ndxw/RemmyMouse/images/20250518_114405.jpg

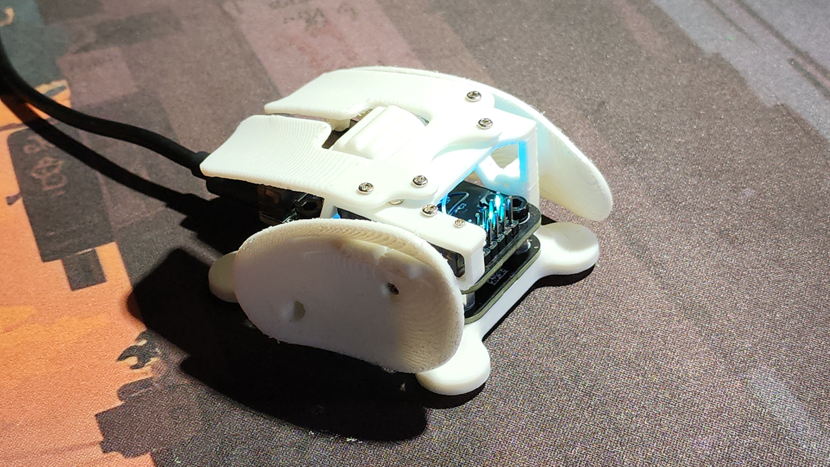
images/20250518_114405.jpg
