ndxw/RemmyMouse/images/20250515_183457.jpg

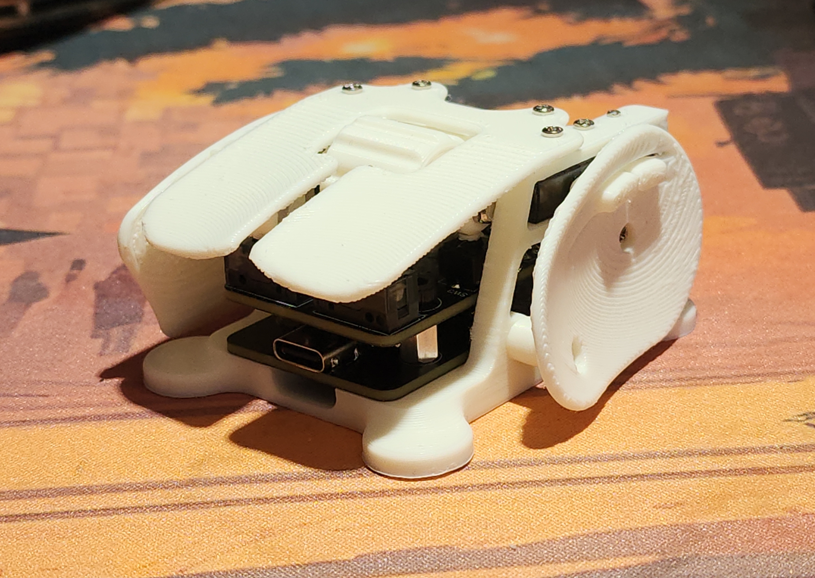
images/20250515_183457.jpg
