ndxw/RemmyMouse/README.md

Remmy uses PJRC's USB mouse library found [here](https://www.pjrc.com/teensy/usb_mouse.html), modified to support five mouse buttons.
