ndxw/RemmyMouse/images/20250515_020344.jpg

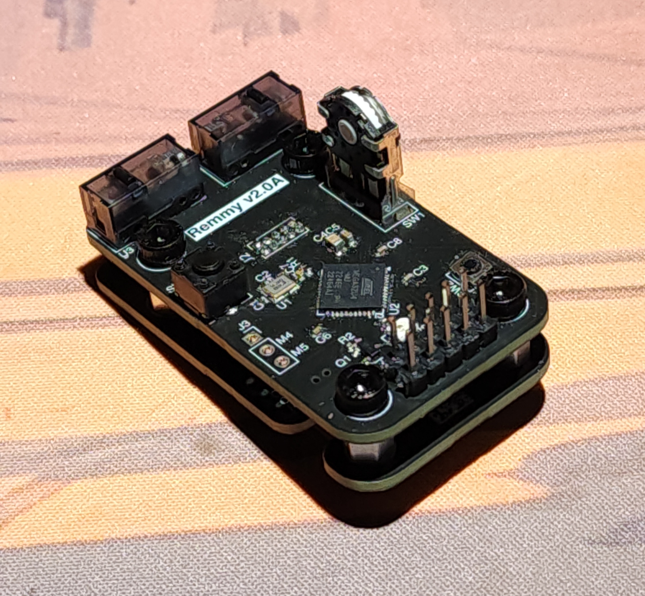
images/20250515_020344.jpg
