ndxw/RemmyMouse/images/20250515_122816.jpg

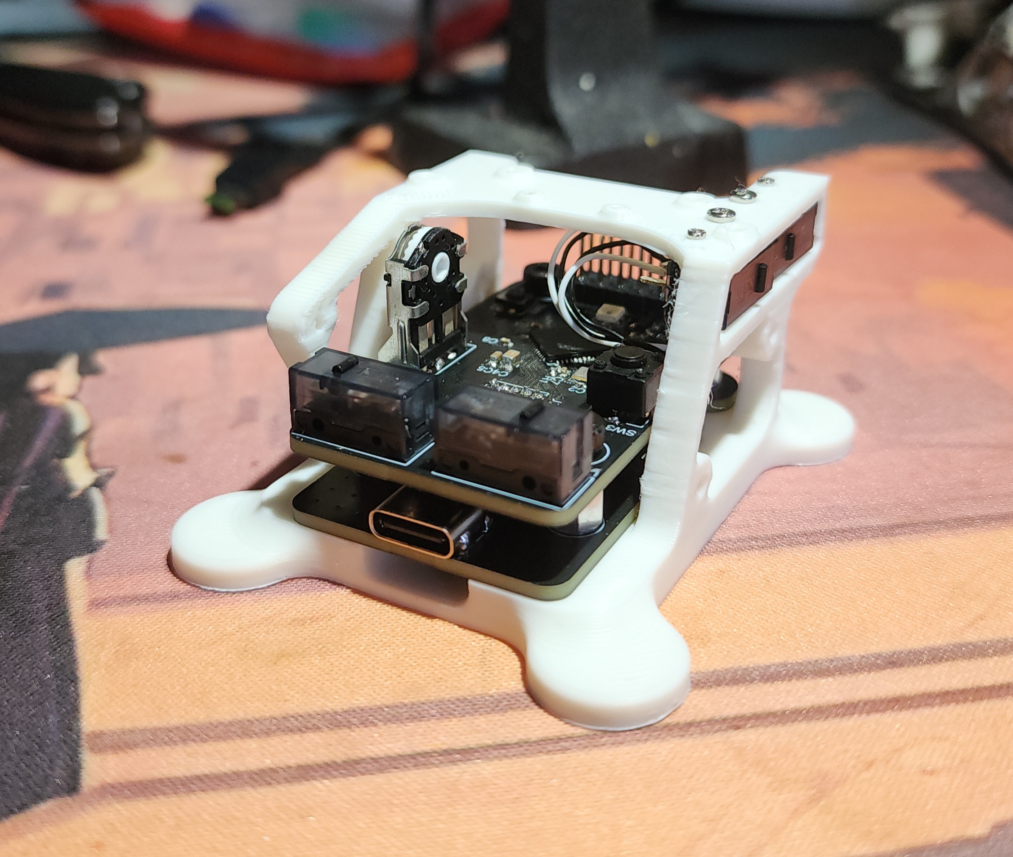
images/20250515_122816.jpg
