ndxw/RemmyMouse/images/20250515_183445.jpg

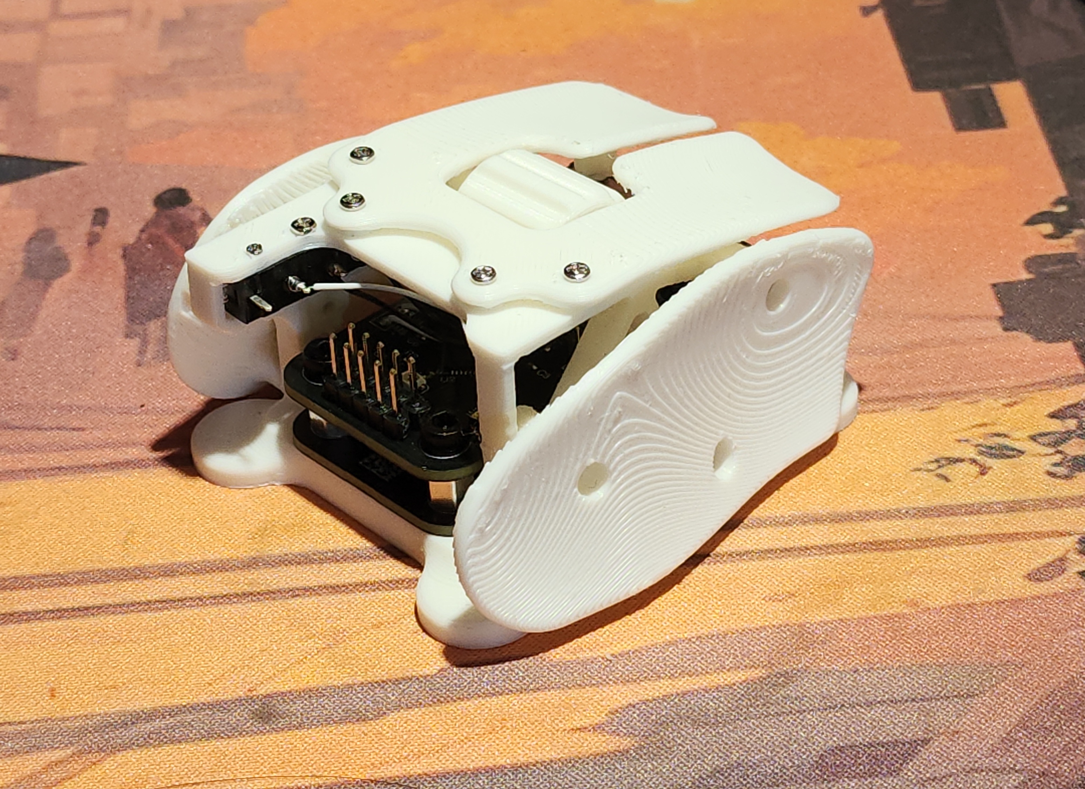
images/20250515_183445.jpg
