ndxw/RemmyMouse/images/20250518_114415.jpg

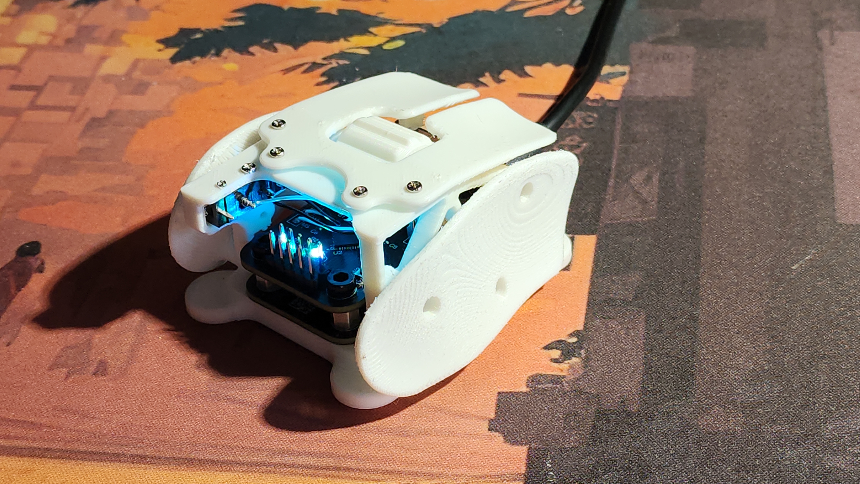
images/20250518_114415.jpg
