ndxw/RemmyMouse/images/20250518_114450.jpg

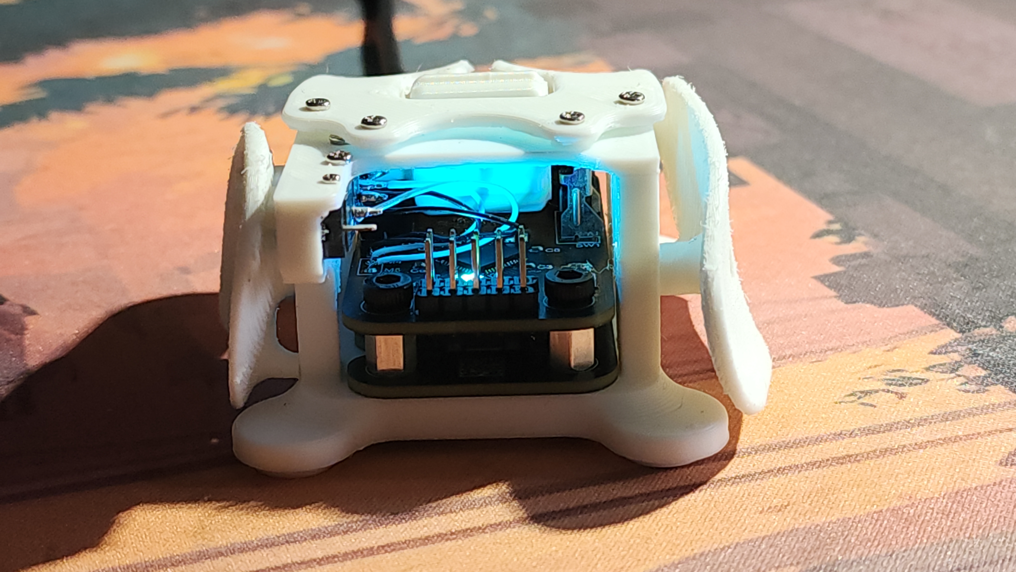
images/20250518_114450.jpg
