ndxw/RemmyMouse/images/remmy_mcu_board_layout.png

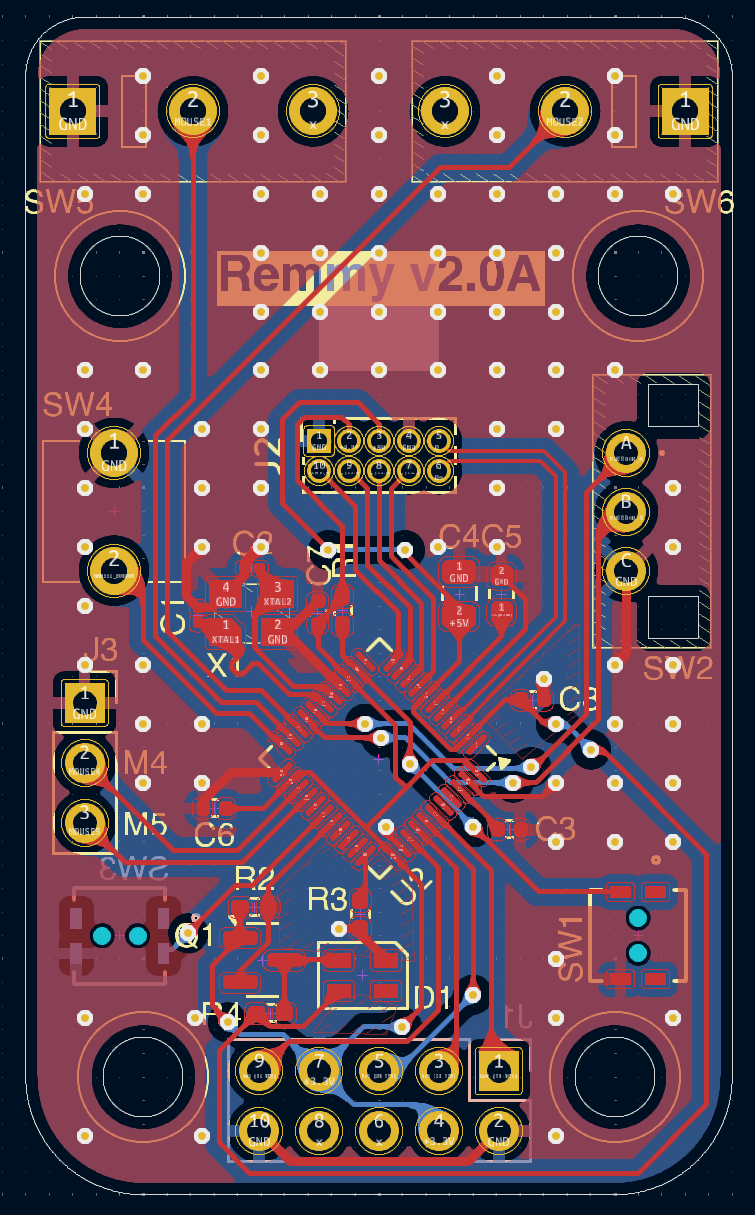
images/remmy_mcu_board_layout.png
