ndxw/RemmyMouse/images/remmy_sensor_board_layout.png

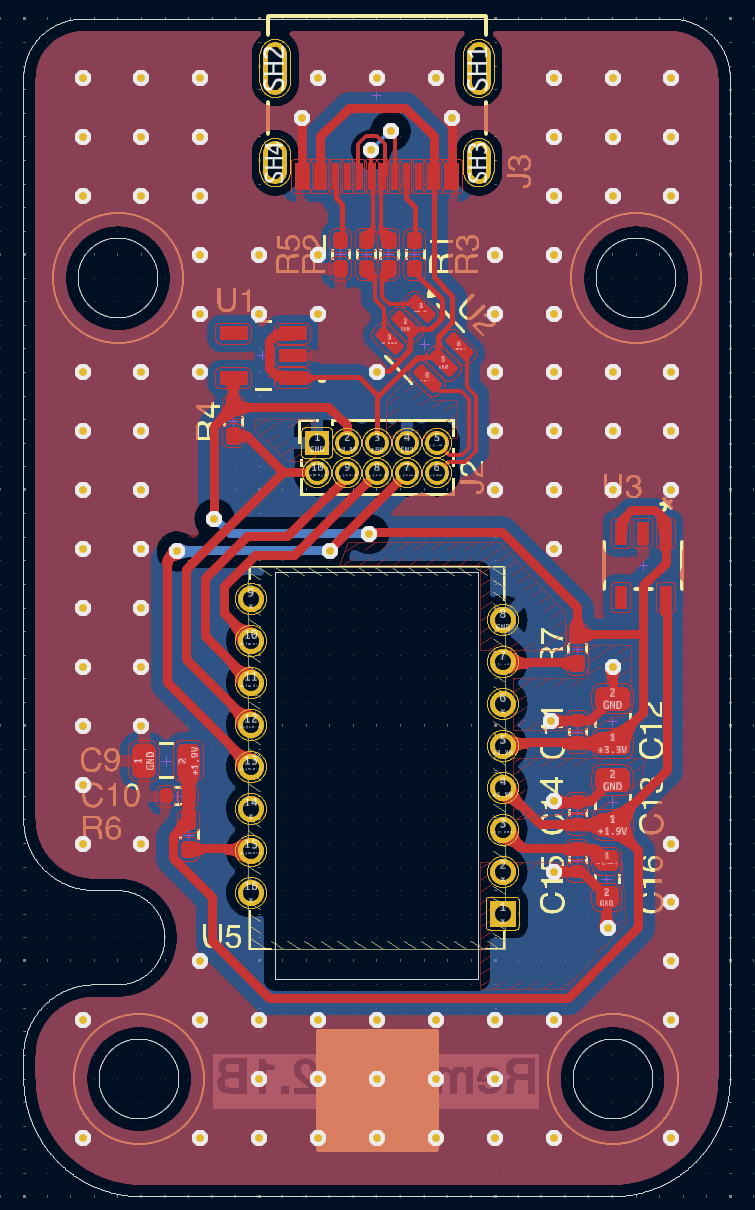
images/remmy_sensor_board_layout.png
