ndxw/RemmyMouse/CAD/shell/stl/thumb_pad_shortened.stl

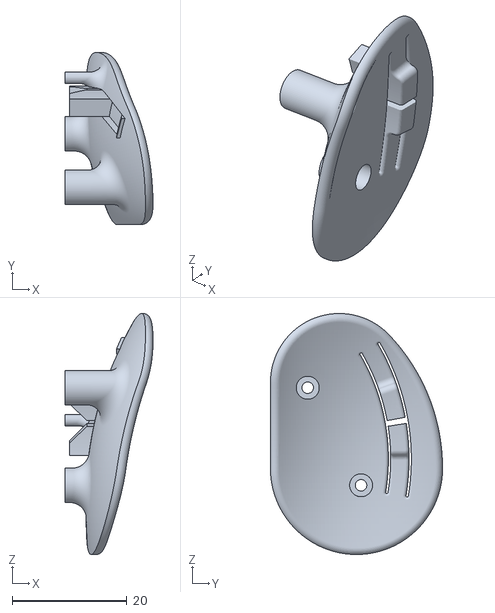
[picture p10: CAD file, 2025-06-22]
CAD/shell/stl/thumb_pad_shortened.stl
15.3 x 30.0 x 42.0
