ndxw/RemmyMouse/CAD/shell/stl/scroll_wheel_with_axle_1.65mm.stl

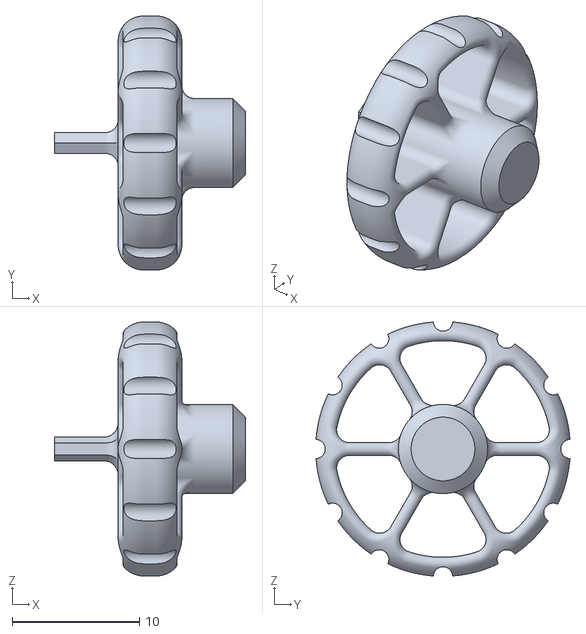
[picture p11: CAD file, 2025-06-22]
CAD/shell/stl/scroll_wheel_with_axle_1.65mm.stl
15.0 x 19.9 x 19.9
