ndxw/RemmyMouse/CAD/shell/stl/pinky_pad_v2.stl

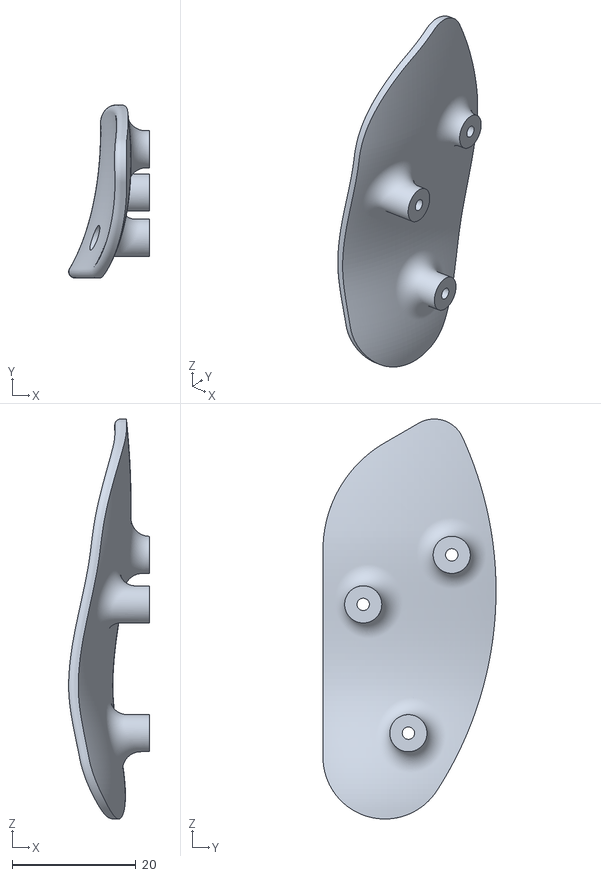
[picture p12: CAD file, 2025-06-22]
CAD/shell/stl/pinky_pad_v2.stl
13.0 x 28.0 x 64.6
