ndxw/RemmyMouse/CAD/shell/stl/mouse_buttons_1-2_reduced_width.stl

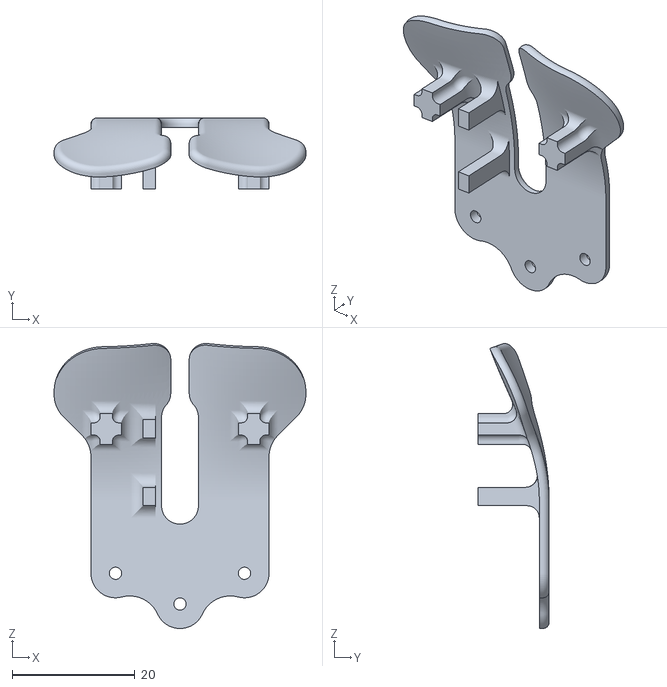
[picture p13: CAD file, 2025-06-22]
CAD/shell/stl/mouse_buttons_1-2_reduced_width.stl
41.0 x 11.6 x 46.4
