ndxw/RemmyMouse/CAD/shell/stl/scroll_wheel.stl

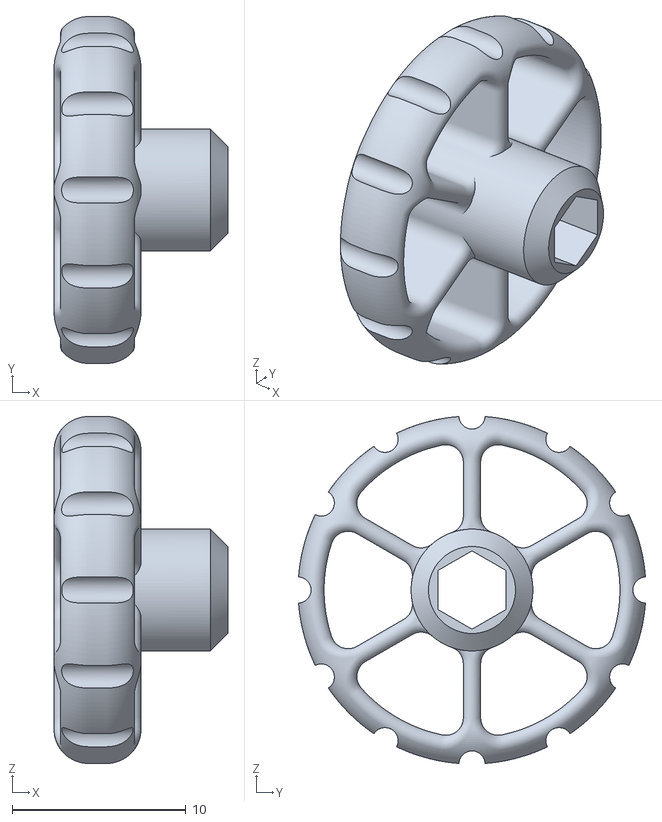
[picture p14: CAD file, 2025-06-22]
CAD/shell/stl/scroll_wheel.stl
10.0 x 19.9 x 19.9
