ndxw/RemmyMouse/CAD/shell/stl/SHELL.3mf

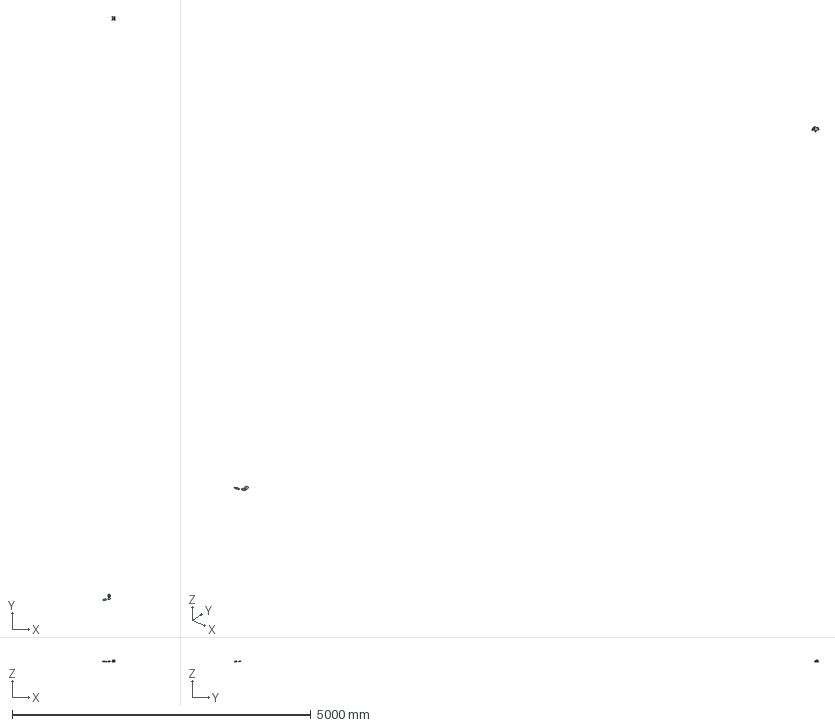
[picture p15: CAD file, 2025-06-12]
CAD/shell/stl/SHELL.3mf
207.3 x 9777.2 x 30.0 mm
base_plate.stl
mouse_buttons_1-2.stl
pinky_pad_v2.stl
thumb_pad_shortened.stl
