ndxw/RemmyMouse/CAD/shell/stl/mouse_buttons_1-2.stl

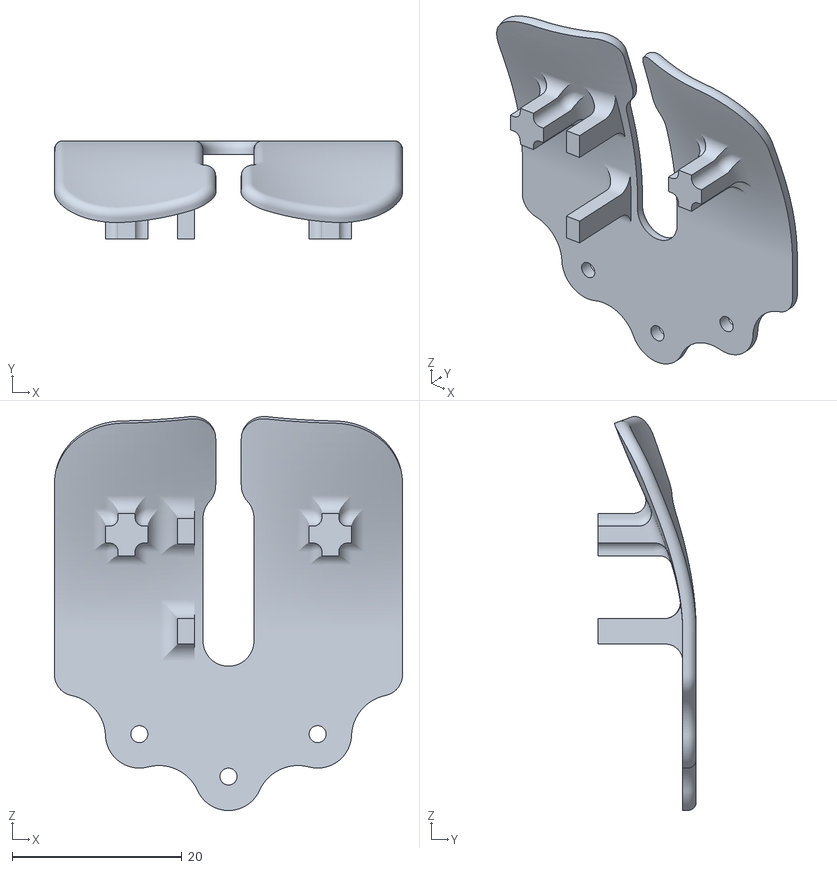
[picture p16: CAD file, 2025-06-12]
CAD/shell/stl/mouse_buttons_1-2.stl
41.0 x 11.6 x 46.4
