ndxw/RemmyMouse/CAD/shell/stl/mouse_button_extension.stl

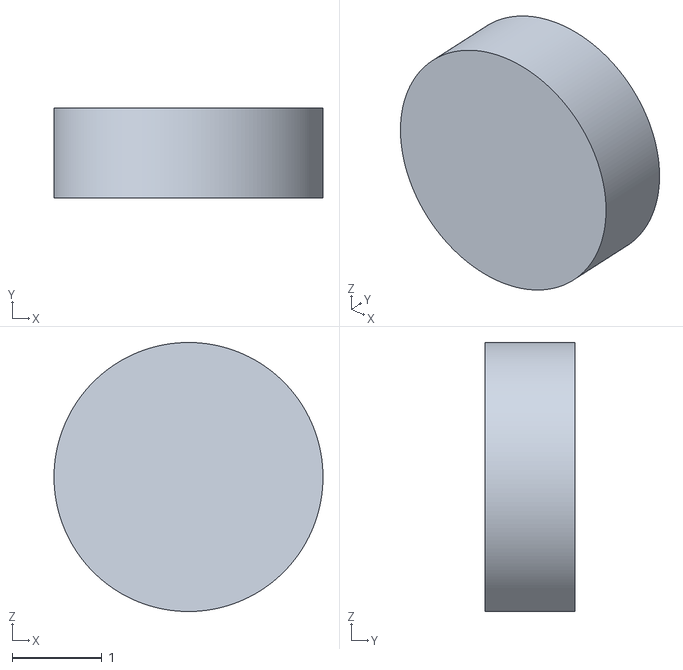
[picture p17: CAD file, 2025-05-16]
CAD/shell/stl/mouse_button_extension.stl
3.00 x 1.00 x 3.00
