ndxw/RemmyMouse/CAD/shell/stl/mwheel_button_extension.stl

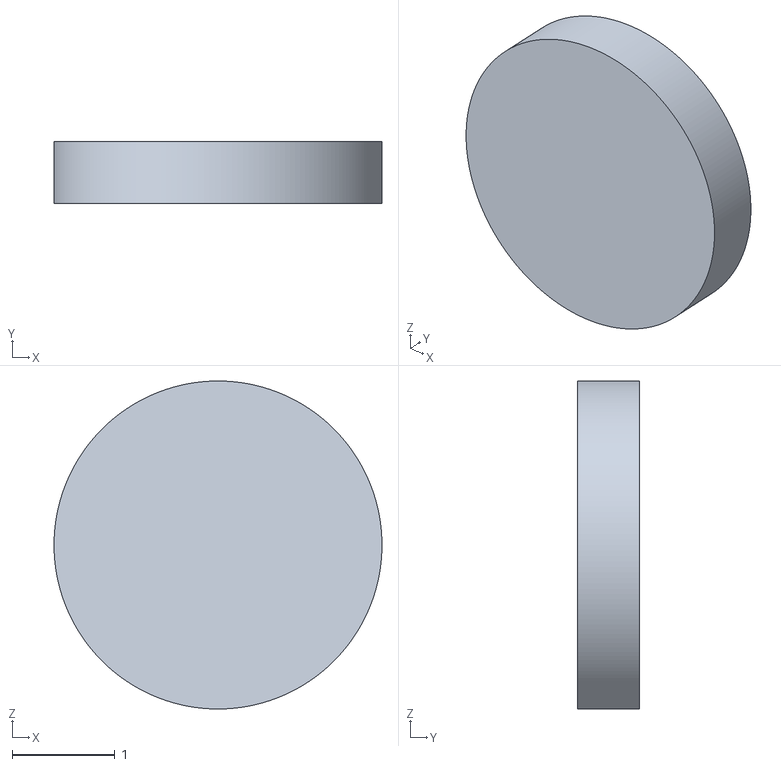
[picture p18: CAD file, 2025-05-16]
CAD/shell/stl/mwheel_button_extension.stl
3.20 x 0.6 x 3.20
