ndxw/RemmyMouse/CAD/shell/stl/temporary_feet.stl

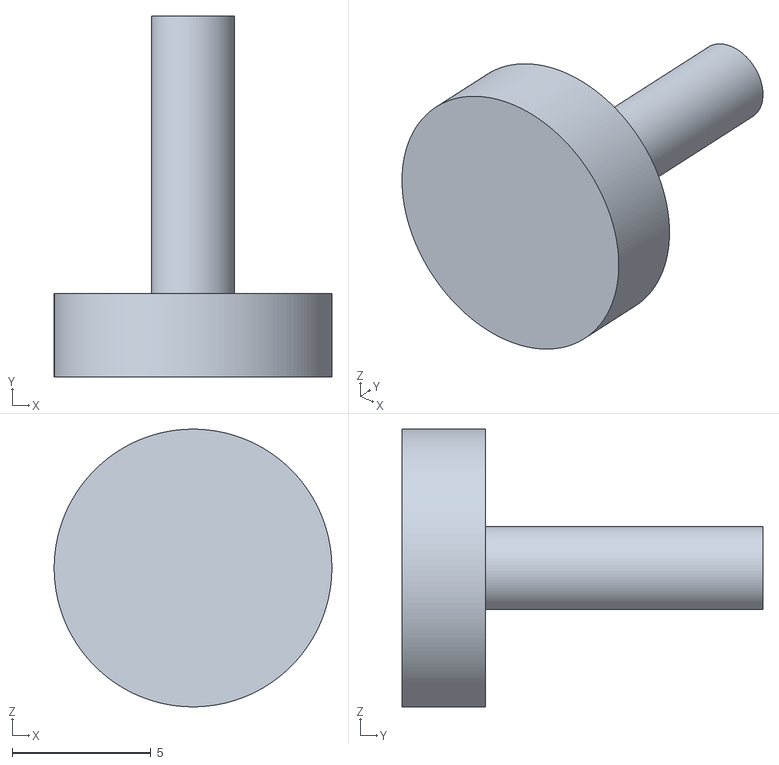
[picture p19: CAD file, 2025-05-16]
CAD/shell/stl/temporary_feet.stl
10.00 x 13.0 x 10.00
