ndxw/RemmyMouse/CAD/shell/stl/TEST.3mf

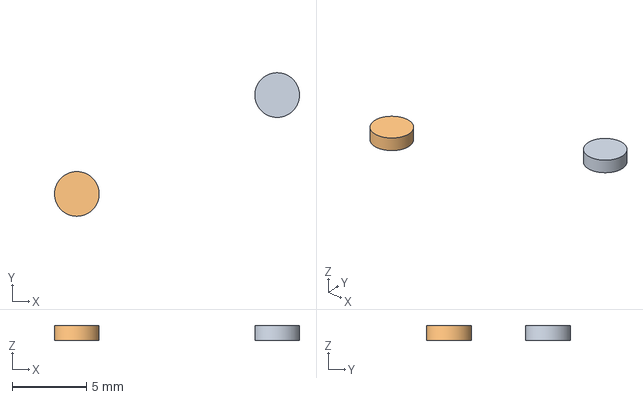
[picture p20: CAD file, 2025-05-16]
CAD/shell/stl/TEST.3mf
16.5 x 9.64 x 1.00 mm
mouse_button_extension.stl x 2
