ndxw/RemmyMouse/CAD/shell/stl/hole_size_test.stl

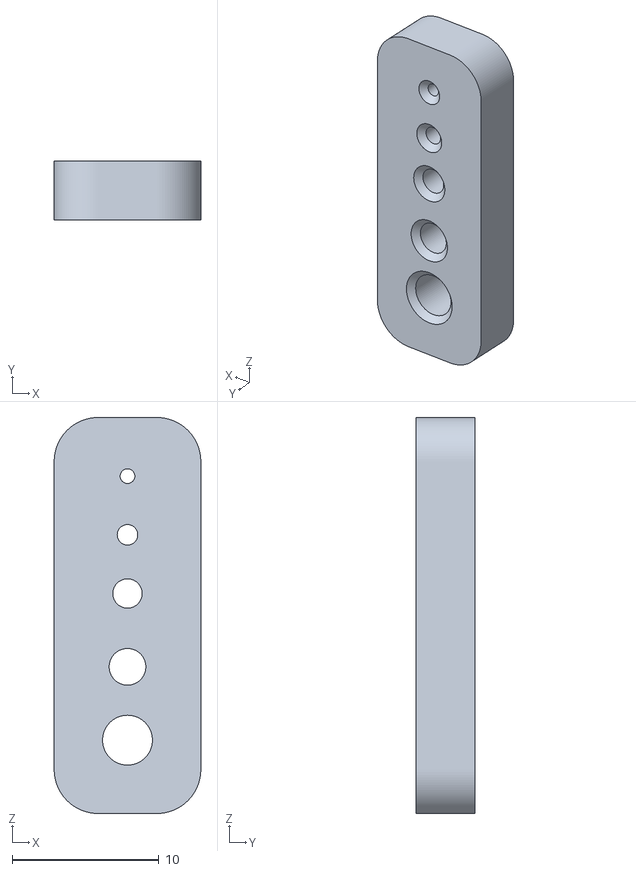
[picture p21: CAD file, 2025-05-15]
CAD/shell/stl/hole_size_test.stl
10.0 x 4.00 x 27.0
