ndxw/RemmyMouse/CAD/shell/stl/base_plate.stl

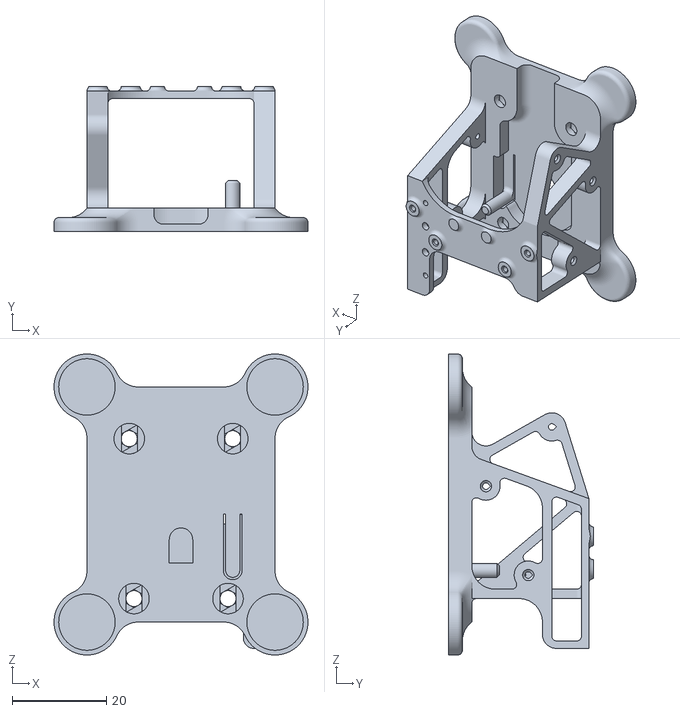
[picture p22: CAD file, 2025-05-15]
CAD/shell/stl/base_plate.stl
54.0 x 30.9 x 64.0
