ndxw/RemmyMouse/(list of files, cad)

Other CAD files:
CAD/shell/stl/scroll_wheel_with_axle.stl
CAD/shell/stl/scroll_wheel_with_axle _1.85mm.stl
CAD/shell/stl/scroll_wheel_with_axle_1.75mm.stl
CAD/2x5_P2.54mm_female_header.ipt
CAD/2x5_P2.54mm_male_header.ipt
CAD/6mm_switch.ipt
CAD/Atmel-ICE_adapter.ipt
CAD/Kailh_GM_8.0_switch.ipt
CAD/LM19-LSI_lens.ipt
CAD/M3_H8.0mm_board_spacer.ipt
CAD/PMW3360_sensor.ipt
CAD/R-667842_tactile_switch.ipt
CAD/TTC_silver_rotary_encoder.ipt
CAD/crystal_oscillator.ipt
CAD/mcu_board.iam
CAD/mcu_label.ipt
CAD/mcu_pcb.ipt
CAD/pan_head_screw_M1.2x4.ipt
CAD/pan_head_screw_M1.6x5.ipt
CAD/quarter.ipt
CAD/remmy.iam
CAD/scroll_wheel.ipt
CAD/scroll_wheel_axle.ipt
CAD/scroll_wheel_no_axle.ipt
CAD/sensor_board.iam
CAD/sensor_pcb.ipt
CAD/shell/base_plate.ipt
CAD/shell/base_plate_ref.ipt
CAD/shell/hole_size_test.ipt
CAD/shell/mouse_button_extension.ipt
CAD/shell/mouse_buttons_1-2.ipt
CAD/shell/mouse_buttons_1-2_reduced_width.ipt
CAD/shell/mwheel_button_extension.ipt
CAD/shell/pinky_pad.ipt
CAD/shell/pinky_pad_shortened.ipt
CAD/shell/pinky_pad_v2.ipt
CAD/shell/scroll_wheel_with_axle _1.85mm.ipt
CAD/shell/scroll_wheel_with_axle_1.65mm.ipt
CAD/shell/scroll_wheel_with_axle_1.75mm.ipt
CAD/shell/temporary_feet.ipt
CAD/shell/thumb_pad.ipt
CAD/shell/thumb_pad_mirrored.ipt
CAD/shell/thumb_pad_shortened.ipt
CAD/socket_head_cap_screw_M3x5.ipt
