ndxw/RemmyMouse/images/remmy_mcu_board_schematic.pdf

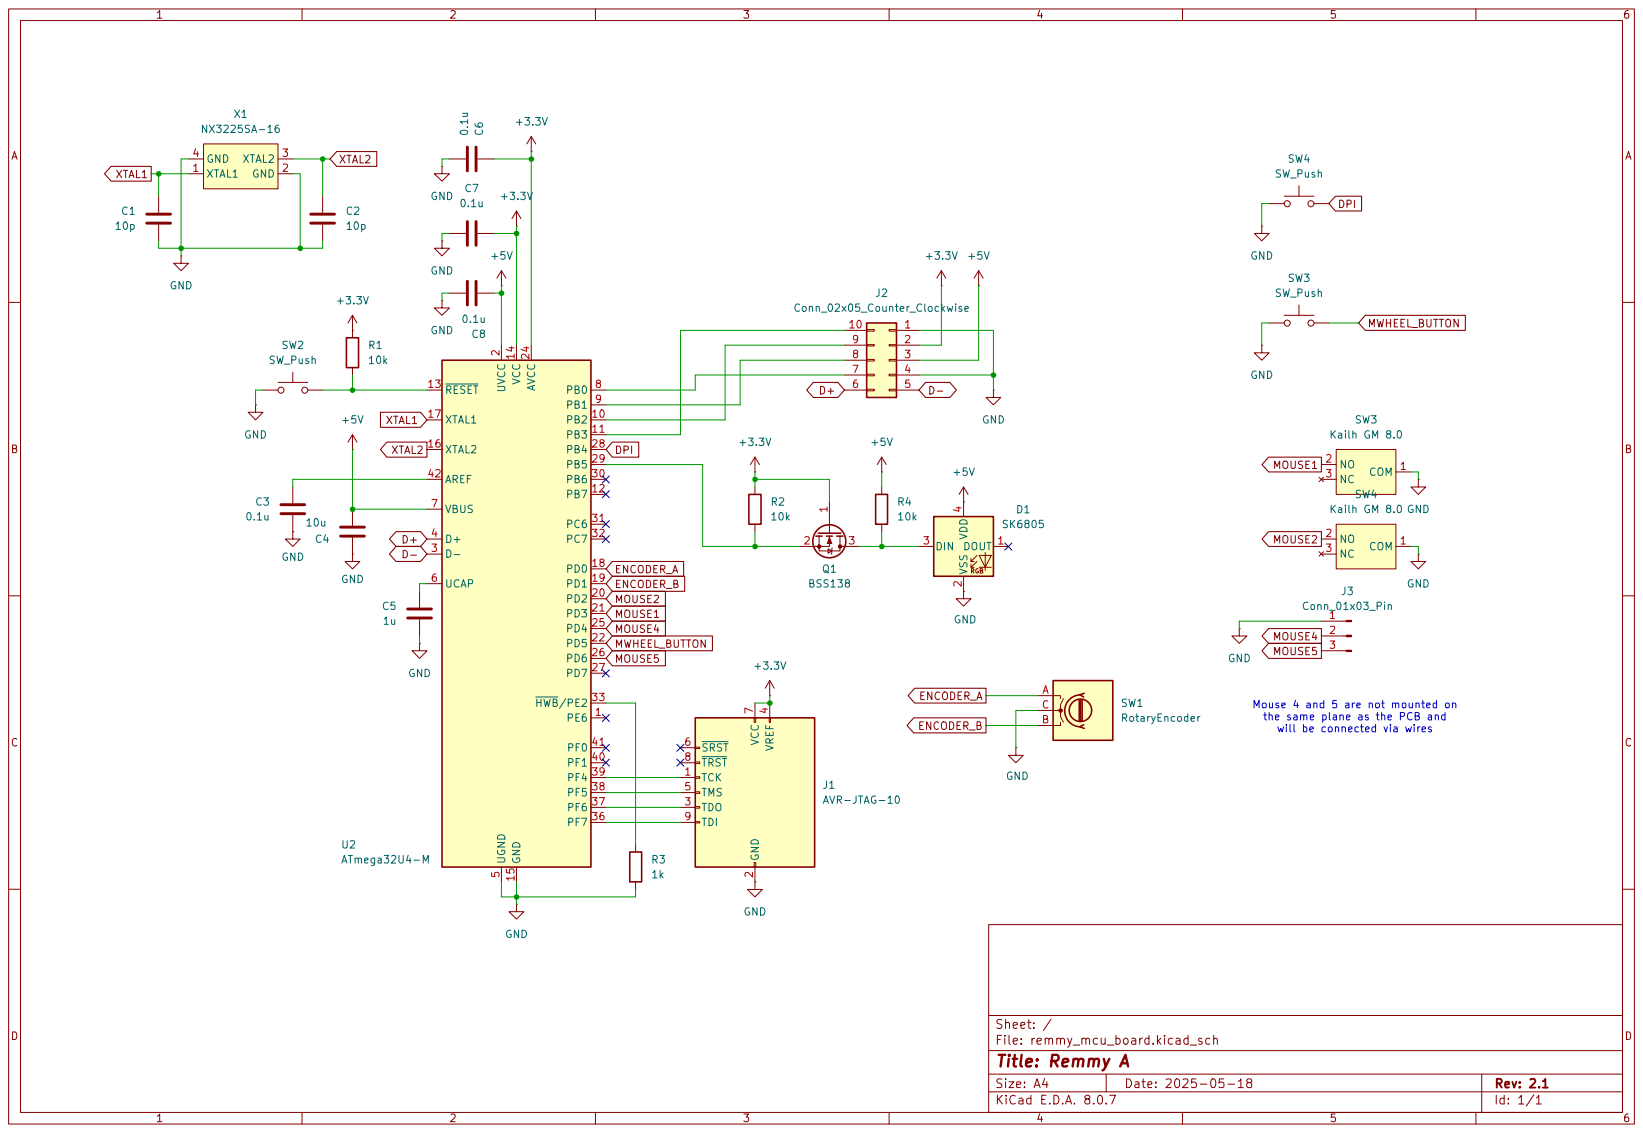
[picture p23: page 1]
