ndxw/RemmyMouse/images/remmy_sensor_board_schematic.pdf

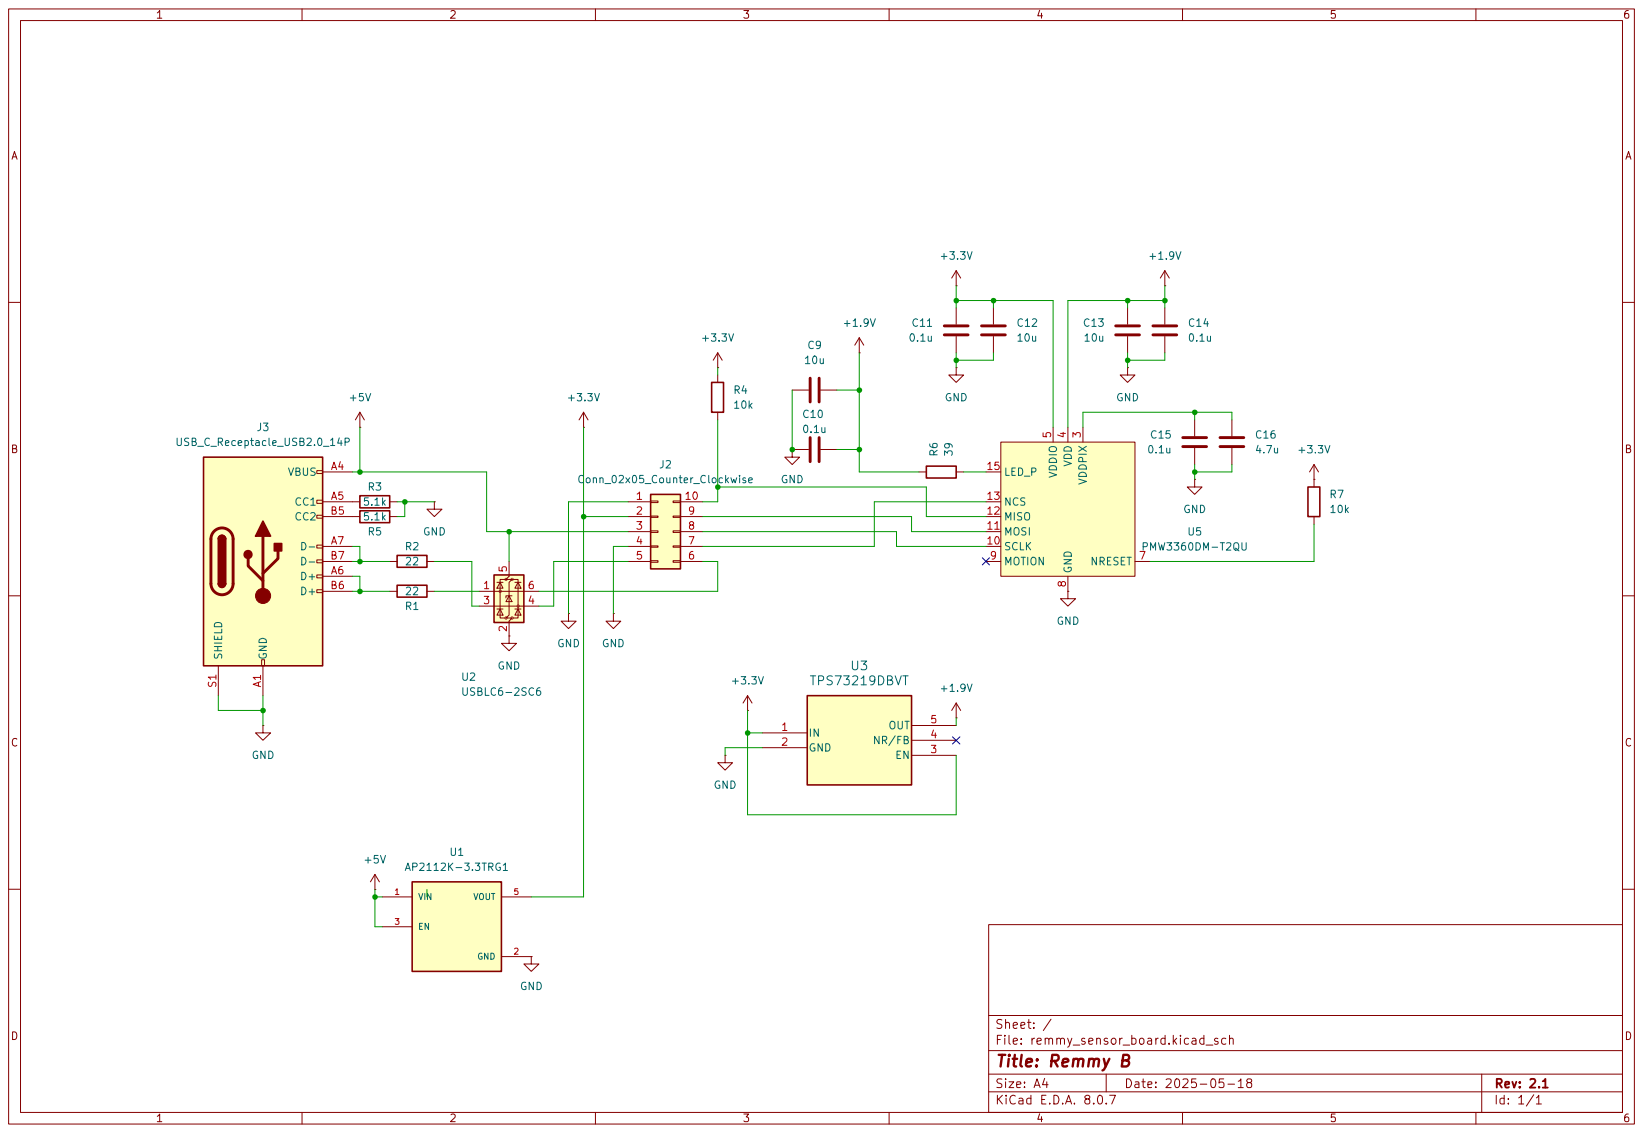
[picture p24: page 1]
