ndxw/RemmyMouse/schematics/remmy_sensor_board/remmy_sensor_board.kicad_pcb

## KiCad design schematics/remmy_sensor_board/remmy_sensor_board.kicad_pcb (2025-06-12)

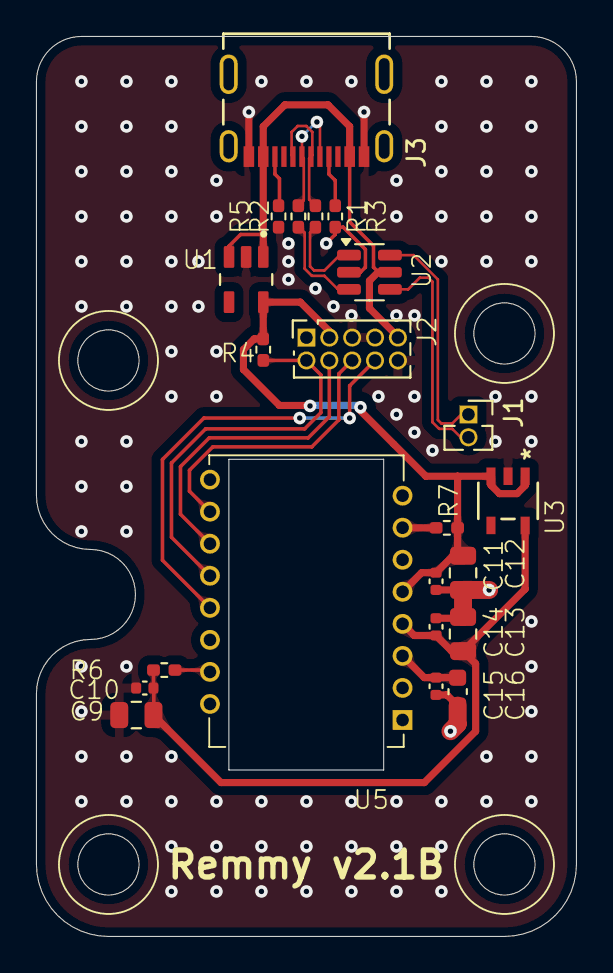
[picture p25: board remmy_sensor_board.kicad_pcb from above]

Board: 2 copper layers, 30.0 x 50.0 mm, 22 parts (0 on the bottom side), 19 nets.

Parts:
C9, C12, C13: 10u; C_0805_2012Metric
C10, C11, C14, C15: 0.1u; C_0402_1005Metric
C16: 4.7u; C_0603_1608Metric
J1: Conn_01x02; PinSocket_1x02_P1.27mm_Vertical
J2: Conn_02x05_Counter_Clockwise; PinSocket_2x05_P1.27mm_Vertical_CW
J3: USB_C_Receptacle_USB2.0_14P; USB-C_16+8_dummy_SMD
R1, R2: 22; R_0402_1005Metric_Pad0.72x0.64mm_HandSolder
R3, R5: 5.1k; R_0402_1005Metric_Pad0.72x0.64mm_HandSolder
R4, R7: 10k; R_0402_1005Metric_Pad0.72x0.64mm_HandSolder
R6: 39; R_0402_1005Metric_Pad0.72x0.64mm_HandSolder
U1: AP2112K-3.3TRG1; SOT95P280X145-5N
U2: USBLC6-2SC6; SOT-23-6
U3: TPS73219DBVT; DBV5_TEX
U5: PMW3360DM-T2QU

Connections:
+1.9V: C9.2, C10.1, C13.1, C14.1, R6.1, U3.5 (OUT), U5.4 (VDD)
+3.3V: C11.1, C12.1, J2.2, R4.1, R7.1, U1.5 (VOUT), U3.1 (IN), U3.3 (EN), U5.5 (VDDIO)
+5V: J2.5, J3.A4 (VBUS), J3.B4 (VBUS), U1.1 (VIN), U1.3 (EN), U2.5 (VBUS)
GND: C9.1, C10.2, C11.2, C12.2, C13.2, C14.2, C15.2, C16.2, J2.1, J2.3, J2.4, J2.6, J3.A1 (GND), J3.B1 (GND), R3.1, R5.2, U1.2 (GND), U2.2 (GND), U3.2 (GND), U5.8 (GND)
unnamed: J1.1, U2.6 (I/O1)
unnamed: J1.2, U2.4 (I/O2)
unnamed: J2.7, U5.13 (NCS)
unnamed: J2.8, U5.10 (SCLK)
unnamed: J2.9, U5.11 (MOSI)
unnamed: J2.10, R4.2, U5.12 (MISO)
unnamed: J3.A5 (CC1), R3.2
unnamed: J3.B5 (CC2), R5.1
unnamed: J3.A6 (D+), J3.B6 (D+), R1.2
unnamed: J3.A7 (D-), J3.B7 (D-), R2.2
unnamed: R1.1, U2.1 (I/O1)
unnamed: R2.1, U2.3 (I/O2)
unnamed: R6.2, U5.15 (LED_P)
unnamed: R7.2, U5.7 (NRESET)
unnamed: C15.1, C16.1, U5.3 (VDDPIX)
