ndxw/RemmyMouse/schematics/remmy_mcu_board/remmy_mcu_board.kicad_pcb

## KiCad design schematics/remmy_mcu_board/remmy_mcu_board.kicad_pcb (2025-06-12)

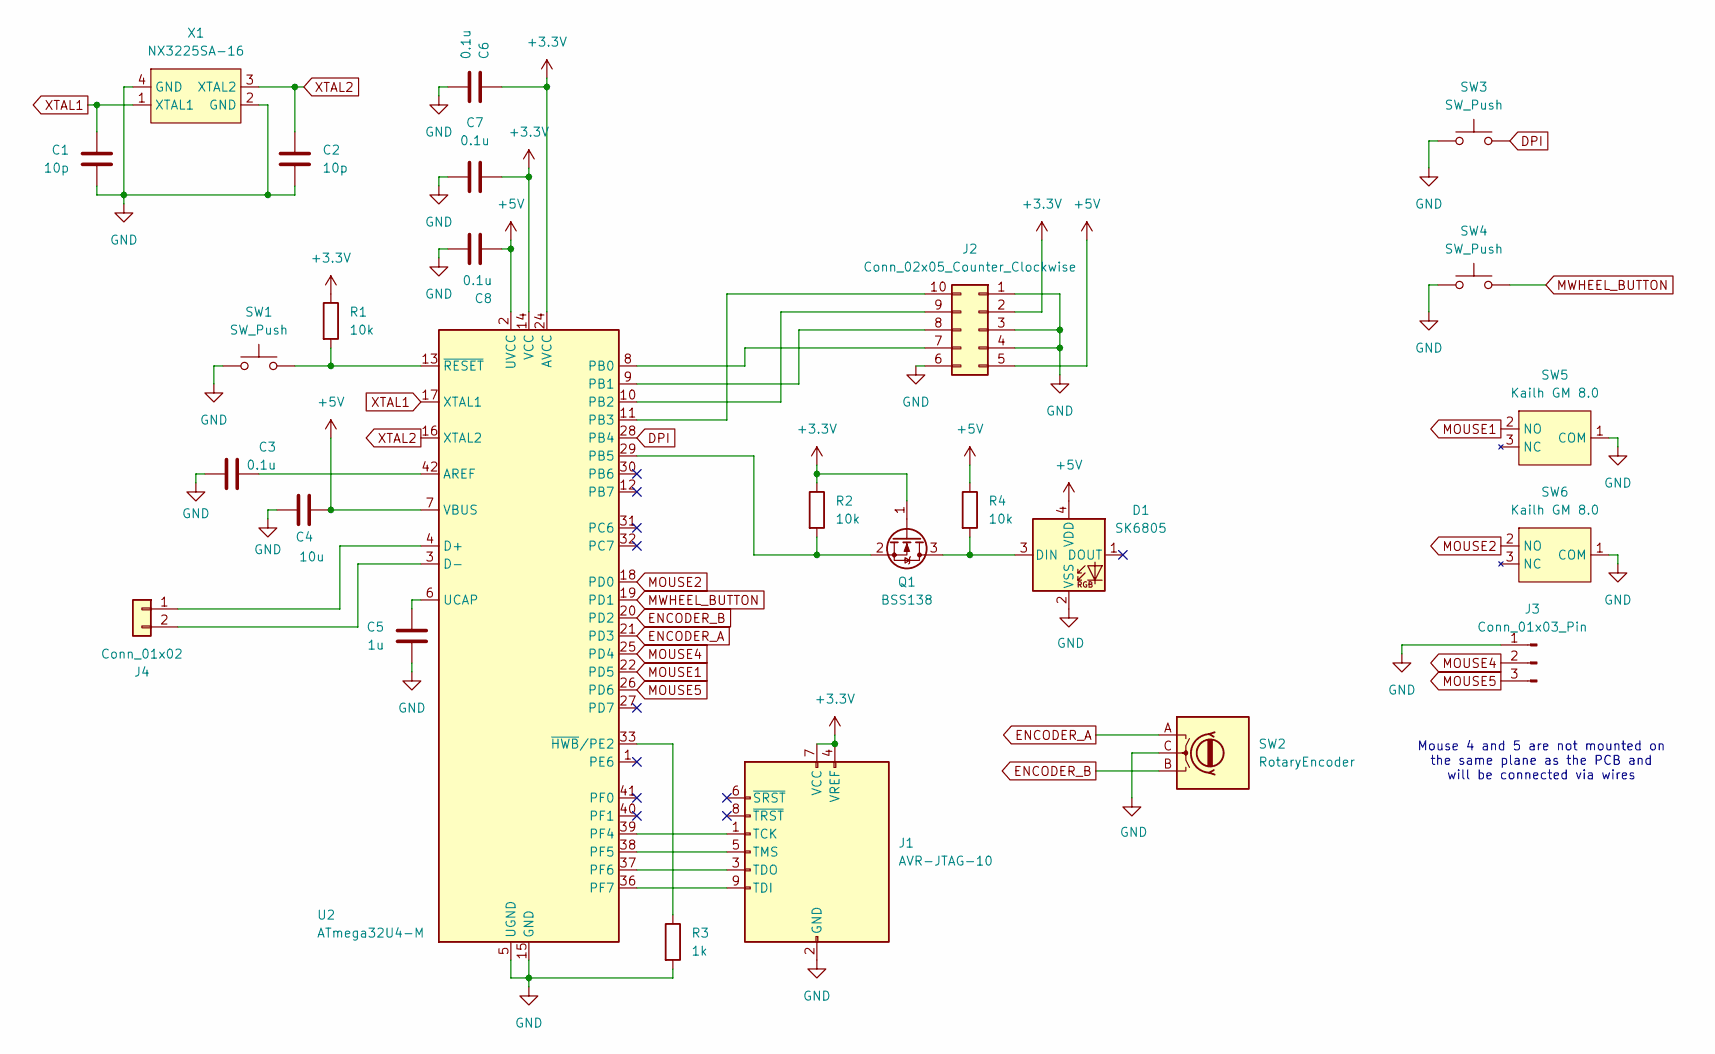
[picture p26: schematic remmy_mcu_board.kicad_sch, Remmy A]

Parts:
C1, C2: 10p; C_0201_0603Metric
C3, C6, C7, C8: 0.1u; C_0402_1005Metric
C4: 10u; C_0805_2012Metric
C5: 1u; C_0603_1608Metric
D1: SK6805; LED_SK6805_PLCC4_2.4x2.7mm_P1.3mm
J1: AVR-JTAG-10; PinSocket_2x05_P2.54mm_Vertical
J2: Conn_02x05_Counter_Clockwise; PinSocket_2x05_P1.27mm_Vertical_CW
J3: Conn_01x03_Pin; PinSocket_1x03_P1.27mm_Vertical
J4: Conn_01x02; PinHeader_1x02_P1.27mm_Vertical
Q1: BSS138; SOT-23
R1, R2, R4: 10k; R_0402_1005Metric_Pad0.72x0.64mm_HandSolder
R3: 1k; R_0402_1005Metric_Pad0.72x0.64mm_HandSolder
SW1, SW3: SW_Push; R-667_MIT
SW2: RotaryEncoder; Encoder_TTC_Silver
SW4: SW_Push; SW_PUSH_6mm
SW5, SW6: Kailh GM 8.0; Kailh_GM_8.0
U2: ATmega32U4-M; QFN-44-1EP_7x7mm_P0.5mm_EP5.2x5.2mm_noGNDPlane
X1: NX3225SA-16; CS14520-16M

Connections:
+3.3V: C6.1, C7.1, J1.4 (VREF), J1.7 (VCC), J2.2, Q1.1 (G), R1.1, R2.1, U2.14 (VCC), U2.24 (AVCC), U2.34 (VCC), U2.44 (AVCC)
+5V: C4.1, C8.2, D1.4 (VDD), J2.5, R4.1, U2.2 (UVCC), U2.7 (VBUS)
DPI: SW3.2, U2.28 (PB4)
ENCODER_A: SW2.A, U2.21 (PD3)
ENCODER_B: SW2.B, U2.20 (PD2)
GND: C1.2, C2.2, C3.1, C4.2, C5.2, C6.2, C7.2, C8.1, D1.2 (VSS), J1.2 (GND), J1.10 (GND), J2.1, J2.3, J2.4, J2.6, J3.1, R3.2, SW1.1, SW2.C, SW3.1, SW4.1, SW5.1 (COM), SW6.1 (COM), U2.5 (UGND), U2.15 (GND), U2.23 (GND), U2.35 (GND), U2.43 (GND), U2.45 (GND), X1.2 (GND), X1.4 (GND)
MOUSE1: SW5.2 (NO), U2.22 (PD5)
MOUSE2: SW6.2 (NO), U2.18 (PD0)
MOUSE4: J3.2, U2.25 (PD4)
MOUSE5: J3.3, U2.26 (PD6)
MWHEEL_BUTTON: SW4.2, U2.19 (PD1)
unnamed: D1.3 (DIN), Q1.3 (D), R4.2
unnamed: J1.1 (TCK), U2.39 (PF4)
unnamed: J1.9 (TDI), U2.36 (PF7)
unnamed: J1.3 (TDO), U2.37 (PF6)
unnamed: J1.5 (TMS), U2.38 (PF5)
unnamed: J2.7, U2.8 (PB0)
unnamed: J2.8, U2.9 (PB1)
unnamed: J2.9, U2.10 (PB2)
unnamed: J2.10, U2.11 (PB3)
unnamed: J4.1, U2.4 (D+)
unnamed: J4.2, U2.3 (D-)
unnamed: Q1.2 (S), R2.2, U2.29 (PB5)
unnamed: C3.2, U2.42 (AREF)
unnamed: C5.1, U2.6 (UCAP)
unnamed: R3.1, U2.33 (~HWB/PE2)
unnamed: R1.2, SW1.2, U2.13 (~RESET)
XTAL1: C1.1, U2.17 (XTAL1), X1.1 (XTAL1)
XTAL2: C2.1, U2.16 (XTAL2), X1.3 (XTAL2)

Notes on the sheet:
Mouse 4 and 5 are not mounted on the same plane as the PCB and will be connected via wires

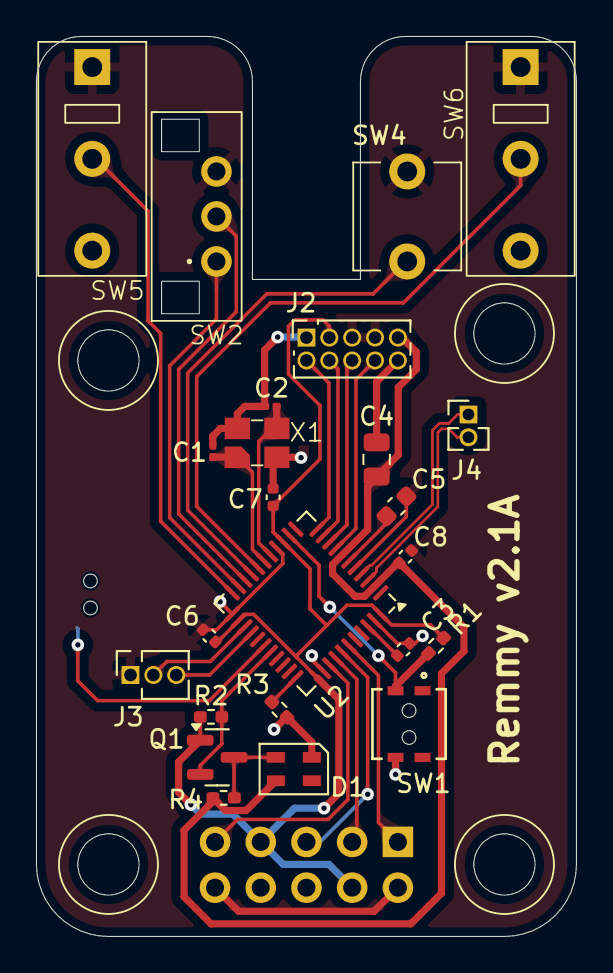
[picture p27: board remmy_mcu_board.kicad_pcb from above]

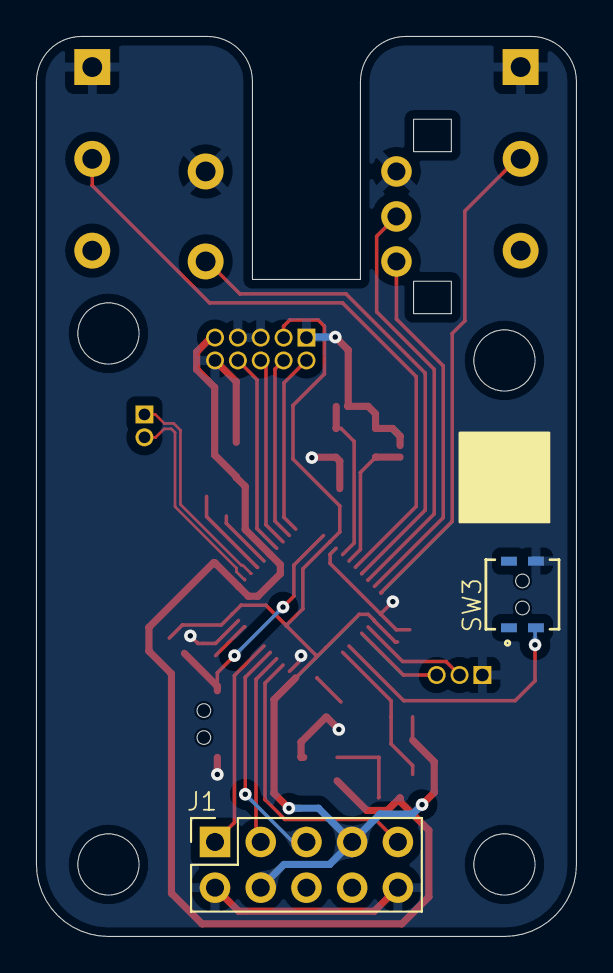
[picture p28: board remmy_mcu_board.kicad_pcb from below]

Board: 2 copper layers, 30.0 x 50.0 mm, 26 parts (2 on the bottom side), 29 nets.
