ndxw/RemmyMouse/schematics/remmy_prototype_board/Mouse.kicad_pcb

## KiCad design schematics/remmy_prototype_board/Mouse.kicad_pcb (2025-05-15)

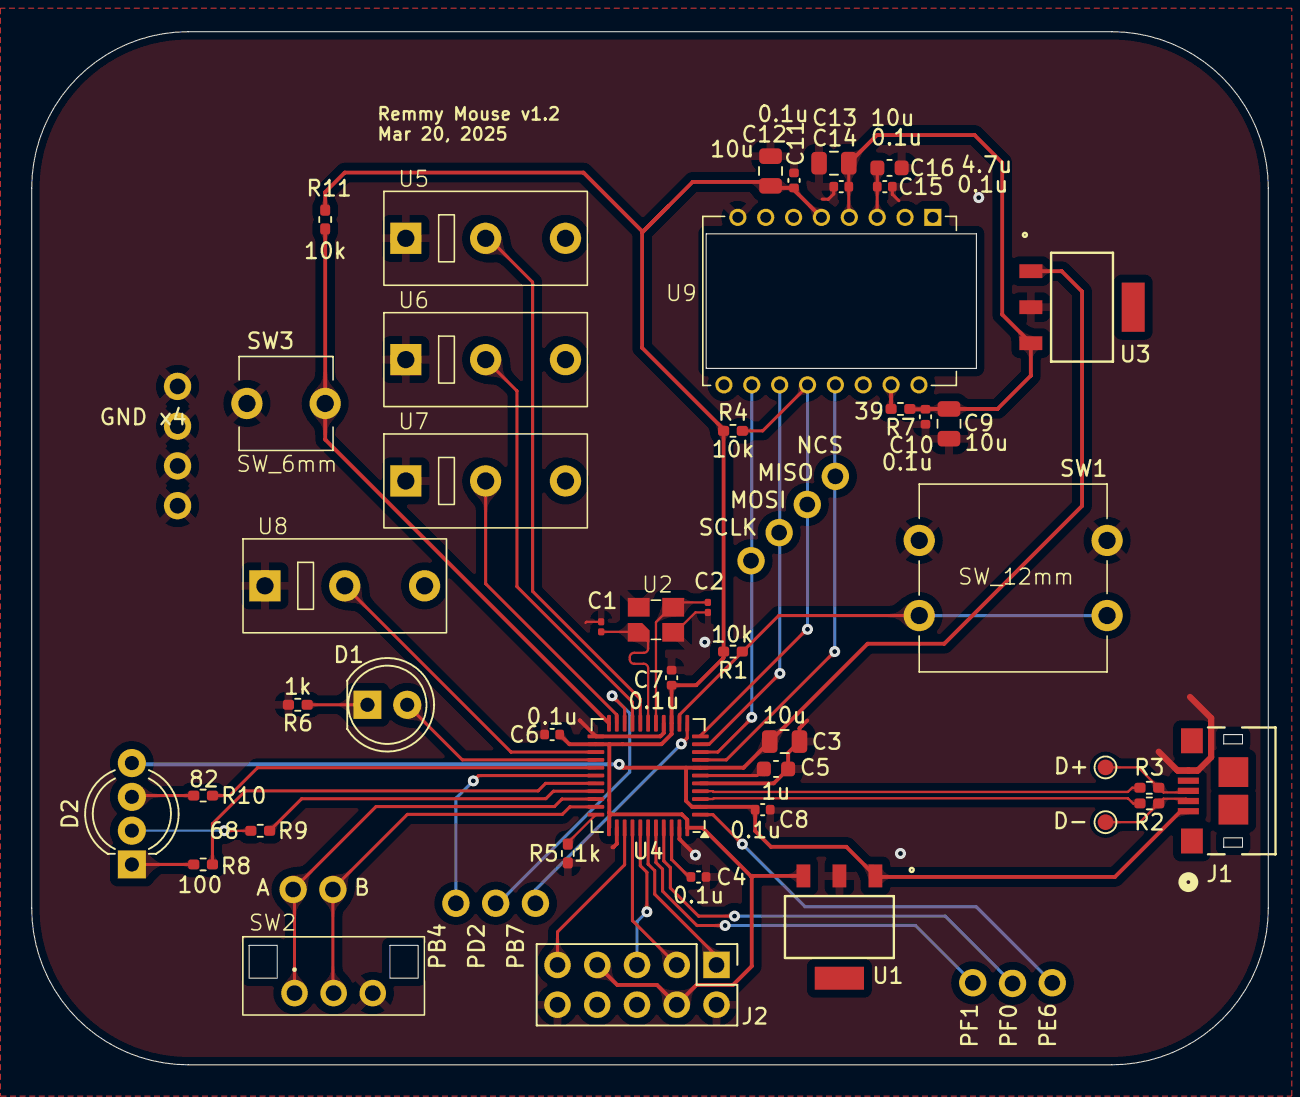
[picture p29: board Mouse.kicad_pcb from above]

Board: 2 copper layers, 79.0 x 66.0 mm, 61 parts (0 on the bottom side), 45 nets.

Parts:
C1, C2: 10p; C_0201_0603Metric
C3, C9, C12, C13: 10u; C_0805_2012Metric
C4, C6, C7, C8, C10, C11, C14, C15: 0.1u; C_0402_1005Metric
C5: 1u; C_0603_1608Metric
C16: 4.7u; C_0603_1608Metric
D1: LED; LED_D5.0mm
D2: LED_RGBA; LED_D5.0mm-4_RGB_Wide_Pins
J1: USB_B_Micro; CONN_10118193-0001LF_AMP_MicroUSB-B
J2: AVR-JTAG-10; PinSocket_2x05_P2.54mm_Vertical
R1, R4, R11: 10k; R_0402_1005Metric_Pad0.72x0.64mm_HandSolder
R2, R3: 22; R_0402_1005Metric_Pad0.72x0.64mm_HandSolder
R5, R6: 1k; R_0402_1005Metric_Pad0.72x0.64mm_HandSolder
R7: 39; R_0402_1005Metric_Pad0.72x0.64mm_HandSolder
R8: 100; R_0402_1005Metric_Pad0.72x0.64mm_HandSolder
R9: 68; R_0402_1005Metric_Pad0.72x0.64mm_HandSolder
R10: 82; R_0402_1005Metric_Pad0.72x0.64mm_HandSolder
SW1: SW_Push; SW_PUSH_12mm
SW2: RotaryEncoder; Encoder_TTC_Silver
SW3: SW_Push; SW_PUSH_6mm
TP1, TP2: TestPoint; TestPoint_Pad_D1.0mm
TP3, TP4, TP5, TP6, TP7, TP8, TP9, TP10, TP11, TP12, TP13, TP14, TP15, TP16, TP17, TP19: TestPoint; TestPoint_THTPad_D1.75mm_Drill1.0mm
U1, U3: MCP1825S; SOT-223_3MC_MCH
U2: NX3225SA-16; CS14520-16M
U4: ATmega32U4-M; QFN-44-1EP_7x7mm_P0.5mm_EP5.2x5.2mm_noGNDPlane
U5, U6, U7, U8: Kailh GM 8.0; Kailh_GM_8.0
U9: PMW3360DM-T2QU

Connections:
+1.9V: C9.1, C10.1, C13.1, C14.1, R7.1, U3.3 (VO), U9.4 (VDD)
+3.3V: C6.1, C7.1, C11.1, C12.1, J2.4 (VREF), J2.7 (VCC), R1.1, R4.1, R11.1, U1.3 (VO), U4.14 (VCC), U4.24 (AVCC), U4.34 (VCC), U4.44 (AVCC), U9.5 (VDDIO)
+5V: C3.2, C8.2, D2.4 (A), J1.1 (VBUS), U1.1 (VI), U3.1 (VI), U4.2 (UVCC), U4.7 (VBUS)
D+: R2.2, U4.4 (D+)
D-: R3.1, U4.3 (D-)
ENCODER_A: SW2.A, TP7.1, U4.31 (PC6)
ENCODER_B: SW2.B, TP8.1, U4.32 (PC7)
GND: C1.2, C2.2, C3.1, C4.2, C5.2, C6.2, C7.2, C8.1, C9.2, C10.2, C11.2, C12.2, C13.2, C14.2, C15.2, C16.2, J1.5 (GND), J2.2 (GND), J2.10 (GND), R5.2, R6.2, SW1.1, SW2.C, SW3.1, TP9.1, TP16.1, TP17.1, TP19.1, U1.2 (GND), U2.2 (GND), U2.4 (GND), U3.2 (GND), U4.5 (UGND), U4.15 (GND), U4.23 (GND), U4.35 (GND), U4.43 (GND), U5.1 (COM), U6.1 (COM), U7.1 (COM), U8.1 (COM), U9.8 (GND)
LED_RED: D1.2 (A), U4.26 (PD6)
MISO: R4.2, TP6.1, U4.11 (PB3), U9.12 (MISO)
MOSI: TP5.1, U4.10 (PB2), U9.11 (MOSI)
MOUSE1: U4.18 (PD0), U5.2 (NO)
MOUSE2: U4.19 (PD1), U6.2 (NO)
MOUSE4: U4.21 (PD3), U7.2 (NO)
MOUSE5: U4.25 (PD4), U8.2 (NO)
MWHEEL_BUTTON: R11.2, SW3.2, U4.22 (PD5)
NCS: TP3.1, U4.8 (PB0), U9.13 (NCS)
unnamed: D1.1 (K), R6.1
unnamed: D2.3 (BK), R10.2
unnamed: D2.2 (GK), R9.2
unnamed: D2.1 (RK), R8.2
unnamed: J1.3 (D+), R2.1, TP1.1
unnamed: J1.2 (D-), R3.2, TP2.1
unnamed: C4.1, U4.42 (AREF)
unnamed: TP15.1, U4.28 (PB4)
unnamed: TP10.1, U4.12 (PB7)
unnamed: TP11.1, U4.20 (PD2)
unnamed: TP12.1, U4.1 (PE6)
unnamed: TP13.1, U4.41 (PF0)
unnamed: TP14.1, U4.40 (PF1)
unnamed: C5.1, U4.6 (UCAP)
unnamed: R5.1, U4.33 (~HWB/PE2)
unnamed: R7.2, U9.15 (LED_P)
unnamed: C15.1, C16.1, U9.3 (VDDPIX)
RGBA_BLUE: R10.1, U4.27 (PD7)
RGBA_GREEN: R9.1, U4.30 (PB6)
RGBA_RED: R8.1, U4.29 (PB5)
SCLK: TP4.1, U4.9 (PB1), U9.10 (SCLK)
TCK: J2.1 (TCK), U4.39 (PF4)
TDI: J2.9 (TDI), U4.36 (PF7)
TDO: J2.3 (TDO), U4.37 (PF6)
TMS: J2.5 (TMS), U4.38 (PF5)
XTAL1: C1.1, U2.1 (XTAL1), U4.17 (XTAL1)
XTAL2: C2.1, U2.3 (XTAL2), U4.16 (XTAL2)
nRESET: R1.2, SW1.2, U4.13 (~RESET)
