ndxw/RemmyMouse/(commit log)

2025-02-25 init commit
    [Mouse-B_Mask.gbr, Mouse-B_Paste.gbr, Mouse-B_Silkscreen.gbr, Mouse-Back.gbr, Mouse-Edge_Cuts.gbr, Mouse-F_Mask.gbr, Mouse-F_Paste.gbr, Mouse-F_Silkscreen.gbr]
2025-05-15 v2.0 pcb complete, dpi yet to be implemented
    [2x5_P2.54mm_female_header.ipt, 2x5_P2.54mm_male_header.ipt, 6mm_switch.ipt, Atmel-ICE_adapter.ipt, Kailh_GM_8.0_switch.ipt, LM19-LSI_lens.ipt, M3_H8.0mm_board_spacer.ipt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]
2025-05-16 fixed wheel direction and swapped mouse4/5
    [TEST.3mf, mcu_board.iam, mouse_button_extension.ipt, mouse_button_extension.stl, mouse_buttons_1-2.ipt, mouse_buttons_1-2.stl, mwheel_button_extension.ipt, mwheel_button_extension.stl]
2025-05-18 completed dpi button
2025-05-18 added images
    [Mouse_BOM.csv, remmy.iam, remmy_mcu_board.kicad_pcb, remmy_mcu_board.kicad_sch, remmy_sensor_board.kicad_pcb, remmy_sensor_board.kicad_sch]
2025-05-18 rm sample firmware
2025-06-12 broken spi comm
    [6mm_switch.ipt, SHELL.3mf, base_plate.ipt, base_plate_ref.ipt, mcu_board.iam, mcu_pcb.ipt, mouse_buttons_1-2.ipt, mouse_buttons_1-2.stl]
2025-06-22 updated shell model
    [base_plate.ipt, mcu_board.iam, mouse_buttons_1-2.ipt, mouse_buttons_1-2_reduced_width.ipt, mouse_buttons_1-2_reduced_width.stl, pinky_pad_v2.ipt, pinky_pad_v2.stl, remmy.iam]
